gcallipo/RadioDSP_SDR_RX/Schematic_SDR_AUDIO_module.jpg

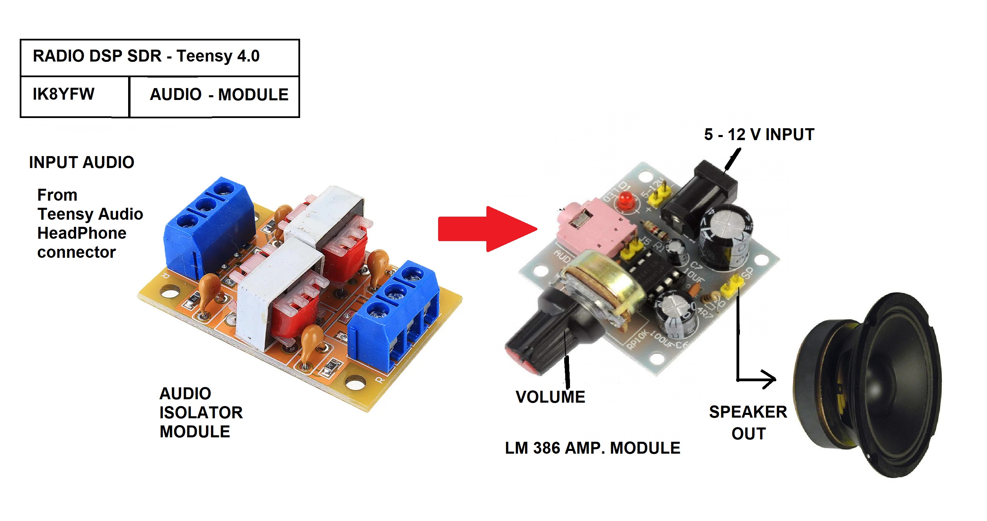
Schematic_SDR_AUDIO_module.jpg
