gcallipo/RadioDSP_SDR_RX/Schematic_SDR_RX_module.jpg

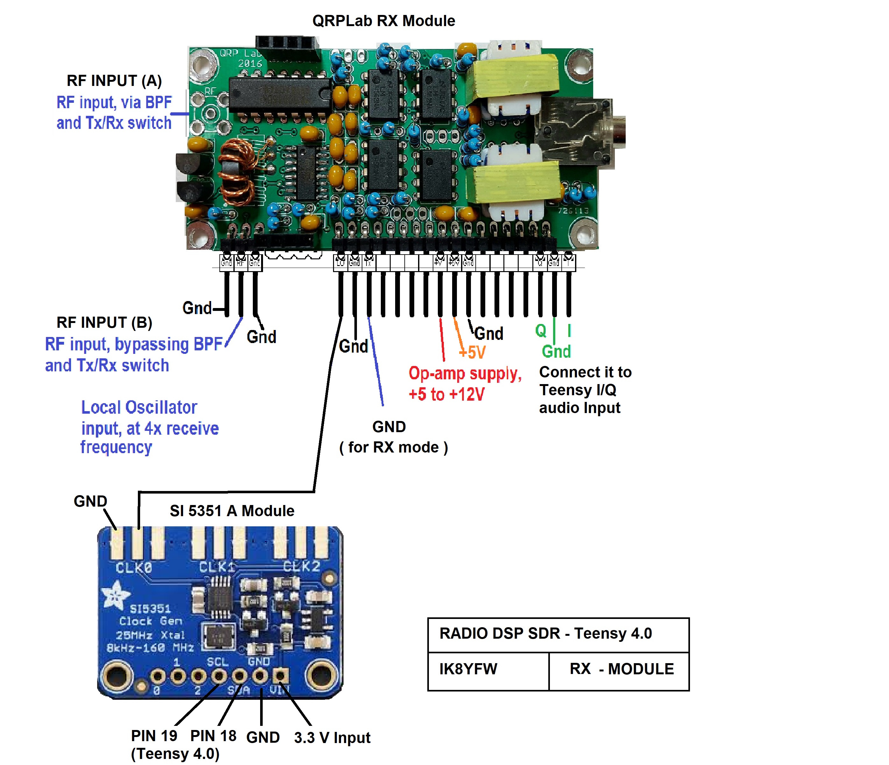
Schematic_SDR_RX_module.jpg
