gcallipo/RadioDSP_SDR_RX/README.md

# RadioDSP_SDR_RX
This project define a simple shortwave all mode and general coverage Software Defined Radio receiver.

Test reception videos

Video 1: RX 40 mt SSB Listening
https://youtu.be/ZIjYX50kgN4

Video 2: Listening SSB and testing Filters and NR
https://youtu.be/BSlDd761dBY

Video 3: RX 40 mt band SSB test Noise Reduction.
https://youtu.be/gWk815RVQAg

Video 4: RX 20 mt band CW test Noise Reduction on CW signal.
https://youtu.be/HTplyrWu3lA

Video 5: RX 20 mt band CW test Auto Notch filter.
https://youtu.be/WXXLD94oXxc

Video 6: RX 40 mt band SSB, extreme QRM noise corrupted signal and Noise reduction action.
https://youtu.be/_-evbWLCN_s

NOTE:
(Updated on 21.02.2021)
