gcallipo/RadioDSP_SDR_RX/RX_Screen2.jpg

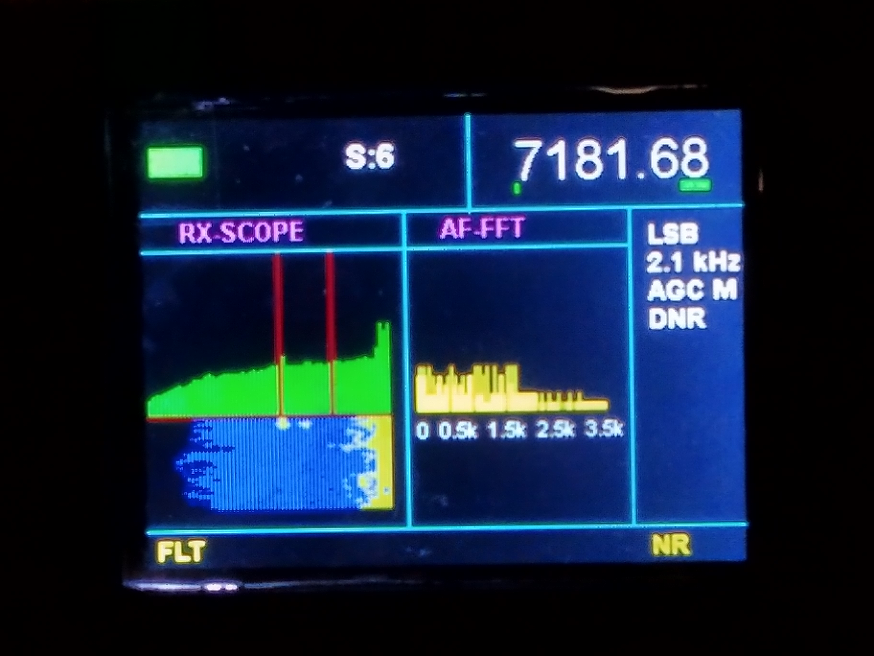
RX_Screen2.jpg
