gcallipo/RadioDSP_SDR_RX/RX_Screen.jpg

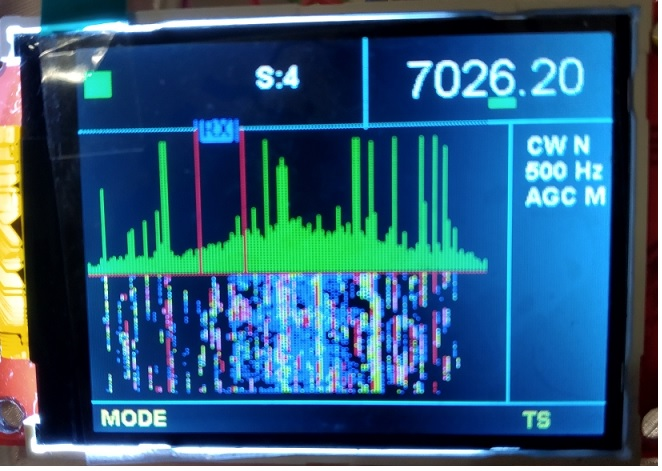
RX_Screen.jpg
