gcallipo/RadioDSP_SDR_RX/Schematic_SDR_CPU_module.jpg

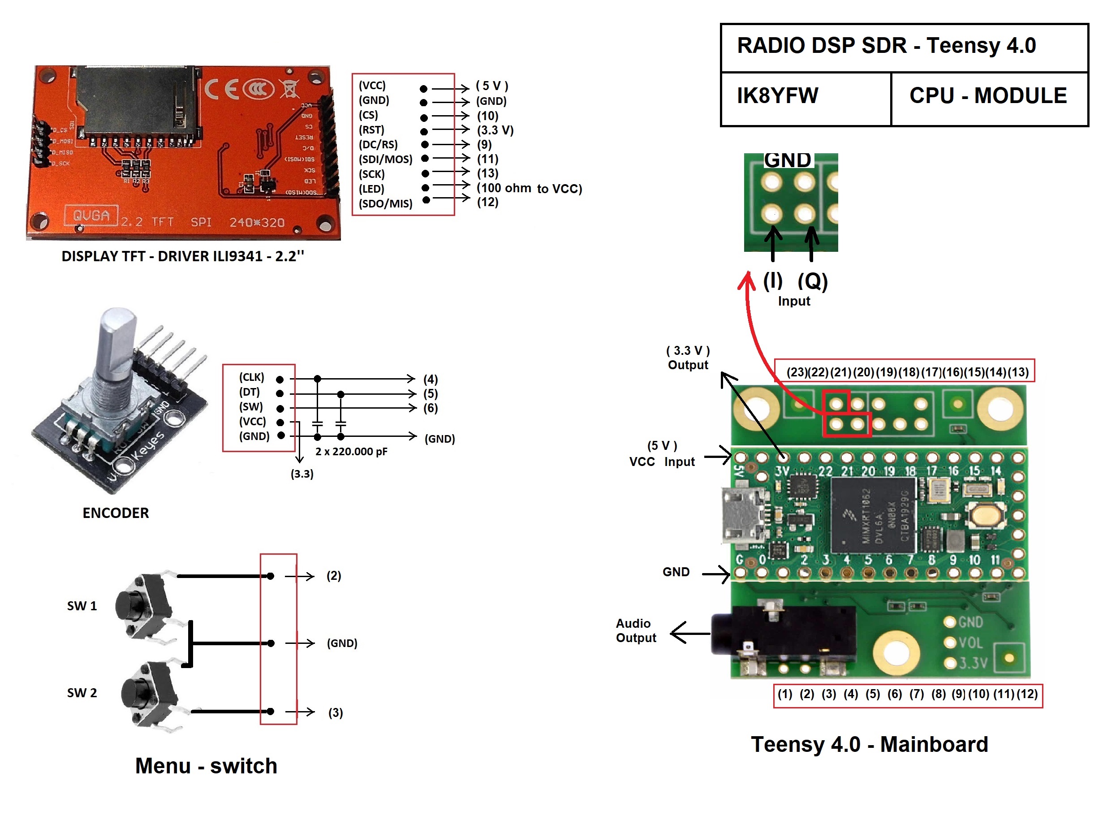
Schematic_SDR_CPU_module.jpg
