gcallipo/RadioDSP_SDR_RX/Schematic_SDR_POWER_module.jpg

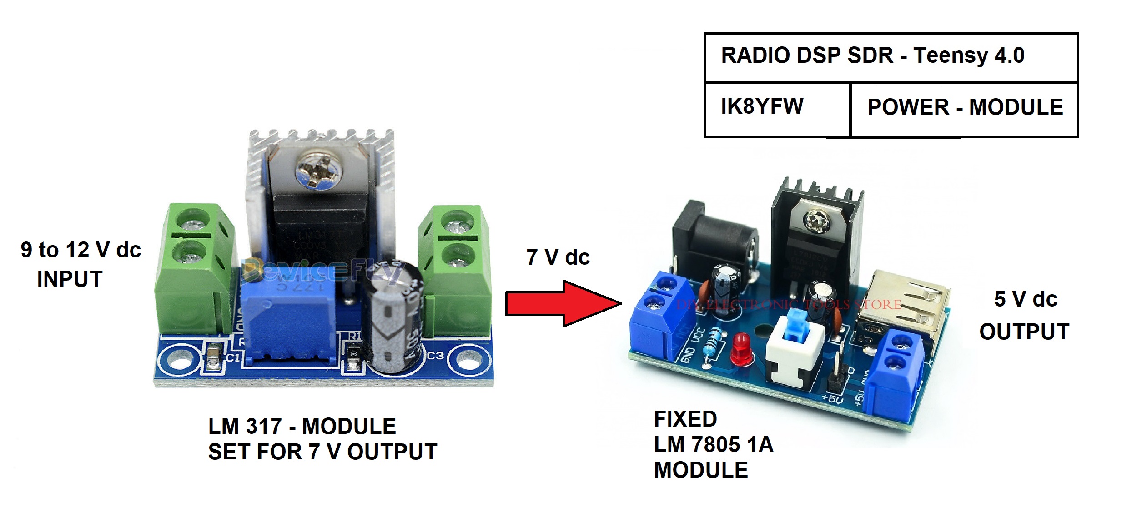
Schematic_SDR_POWER_module.jpg
