gcallipo/RadioDSP_SDR_RX/(threads)

Thread 1 (2021-02-03):

RadioDSP_SDR_RX.

Haranochi, 2021-02-03:
Ciao, voglio conoscere qualche dettaglio in più sul tuo progetto per costruirlo, dove posso ottenere una schema del progetto. Grazie mille.

José María

gcallipo, 2021-02-03:
Hi, thanks for interesting in the project,
I'm working on It and I'm planning to add full descrptiption and schematics in the next weeks.
At the moment you can follows us in two group that we use to build the sdr, the group:.  
https://groups.io/g/keithsdr
And the Facebook group.   keiths_sdr
I'm working starting from an idea of the work that me, Keith and other OMS are started and create my own project with other functionality.
I Hope  to see you in the groups .
Best 73 de Giuseppe Ik8yfw

Inviato da Libero Mail per Android mercoledì, 03 febbraio 2021, 04:28PM +01:00 da Haranochi  notifications@github.com :

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

Haranochi, 2021-02-03:
Hi,
Thank you for responding quickly, I have requested to join the group https://groups.io/g/keithsdr and I await the approval of the moderator.
I follow your project with great interest. Thank.

José María

Closed 2021-02-03.

Thread 2 (2021-02-15):

New questions.

Haranochi, 2021-02-15:
Hi Giuseppe,
 When I got home from the Faculty I visited your github page and I verify that you put the diagrams of your project (test) of the sdr receiver that you have built. Thanks for the time and effort.

When I look at the .ino files in the src folder, I see two more folders, RadioDSP_SDR_RX and tests.

In the RDSP_general_includes.h file, lines 49, 50 and 51.

 // Define 3 buttons for menu operation
#define BUTTON_D2  2 // Switch 1
#define BUTTON_D3  6 // Encoder switch
#define BUTTON_D6  3 // Switch 2

Additional comments are notes to me.

In the test file, RadioDSP_SDR_RX_Conv.ino:

// Define 3 buttons for menu operation
#define BUTTON_D2  2
#define BUTTON_D3  3
#define BUTTON_D6  6

In the file RDSP_general_includes.h, BUTTON_D3 6 and BUTTON_D6 3, my question why you change those pins.

I have compiled with no errors, just two warnings, the RadioDSP_SDR_RX sketch. Now I just have to build it.

Another question why use teensy 4.0 and not 3.6, due to its higher speed ARM.

I want to try compiling the sketch for teensy 3.6, I have an unused one at home and an audio adapter board so I don't have to buy the teensy 4.0 and audio adapter boards for 4.0. or adapt the wiring of the audio adapter boards 3.6 to 4.0. I want to modify arm_math.h file from CMSIS library version 4.5.0, is it possible to do it? If possible I prefer that you do not tell me how, I want to do it myself, if it is not possible please tell me.

Regards,
José María

gcallipo, 2021-02-15:
The tests dir Is Just a backup for some experiments you can skip It.  The project at the moment works on audiosdr library originally created for teensy 3.5/6, then I think that you don't have problems to recompile It on 3.6.  If you see some lack on running you can turn off the Convolutional and Noise reduction section to reduce load.
The project Is quite completed I've to adjust and fix some minor bug on menù and mybe to change the si5351  library for the best si5351mcu to reduce noise on frequency change.
That's all for now.
Thanks for your interest on project.
Best wishes G.
--
Inviato da Libero Mail per Android lunedì, 15 febbraio 2021, 11:12PM +01:00 da Haranochi  notifications@github.com :

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

gcallipo, 2021-02-15:
For the CMSIS I don't try in this project. I worked on stm32 platform and changed also some versions, but here,  I don't know if an upgrade can create problems on original Teensy basic audio library or the audiosdr. Check both the library references: Teensy audio library and the audio are lib.
G.
--
Inviato da Libero Mail per Android lunedì, 15 febbraio 2021, 11:12PM +01:00 da Haranochi  notifications@github.com :

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

Closed 2021-02-20.

Thread 3 (2021-03-03):

Receiver built in stripboard.

Haranochi, 2021-03-03:
Hi,

Finally the board 4.0 arrived, and I finished the construction of the receiver, now it is a frankenstein, there are more cables because I have used the audio adapter rev.B the next step is to design the pcb, I will do three and I can send you one if he wants her. The display used is 2.4 ".

Regards.

José María
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

gcallipo, 2021-03-03:
Really impressive It look great ,
Thanks for posting you result.
I Hope to continue the experiments
In the next weeks, I Will works only
In the firmware without changing the
Hardware.
Stay tuned for updates.
Vy 73 de IK8YFW.
--
Inviato da Libero Mail per Android mercoledì, 03 marzo 2021, 11:04PM +01:00 da Haranochi  notifications@github.com :

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

Thread 4 (2021-03-25):

Receiver finalized.

Haranochi, 2021-03-25:
Hi,

I finished my second semester exams and I was able to finish the receiver, thanks for your software, so that the rotary encoder works in a clockwise direction I have changed the wiring, CLK pin 5 and DT pin 4, I look forward to PBT L and PBT H be active. Now I have time to have fun with the receiver.

Regards.

José María
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

gcallipo, 2021-03-25:
That's good notice. To use the Low and High cut filtering, take the related func button pressed when rotate the tuning control. This Dynamic filter help you to change upper or lower side of filter.
Have a nice listening and stay tuned for news.
73 de IK8YFW
--
Inviato da Libero Mail per Android giovedì, 25 marzo 2021, 10:50PM +01:00 da Haranochi  ***@***.*** :

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

gcallipo, 2021-03-28:
I have a notice that the audiosdr library ( the engine on my project ) have a new release that solve the distorsions problem on AM demodulation. I cannot test It at the moment because I'm working in other sdr chain. If you dewnload It and recompile the project please send me the results of tests if possible.
G.
--
Inviato da Libero Mail per Android giovedì, 25 marzo 2021, 10:50PM +01:00 da Haranochi  ***@***.*** :

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

Haranochi, 2021-03-28:
Hi Guiseppe,

Thanks for your notice, happy to be able to test your new modifications, a question, the files downloaded from your github page once unzipped are dated February 21, these are the ones that contain your latest sdr library. And thanks for showing me how the high and low cut filters work. I send you my comments.

José María

gcallipo, 2021-03-28:
No, the news are in the external library audiosdr that I used in compile, you must download latest audiosdr and recompile my project.
You can find the library here:
https://github.com/DerekRowell/AudioSDR
--
Inviato da Libero Mail per Android domenica, 28 marzo 2021, 01:35PM +02:00 da Haranochi  ***@***.*** :

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

Haranochi, 2021-03-28:
Hi Giuseppe,

After adding the file "core_cm4_simd.h" to / Arduino / teensy / avr / cores / teensy4, it compiled without problems, only three warnings:

RDSP_convolutional.h: In function 'void doConvolutionalProcessing (float, boolean, double, double)':
RDSP_convolutional.h: 231: warning: comparison between signed and unsigned integer expressions
     if (Q_in_L.available ()> N_BLOCKS + 0 && Q_in_R.available ()> N_BLOCKS + 0)

RDSP_convolutional.h: 231: warning: comparison between signed and unsigned integer expressions
     if (Q_in_L.available ()> N_BLOCKS + 0 && Q_in_R.available ()> N_BLOCKS + 0)

RDSP_convolutional.h: 342: warning: comparison between signed and unsigned integer expressions
       for (int i = 0; i <N_BLOCKS; i ++)

RDSP_display.h: In function 'void Update_AudioSpectrum ()':
RDSP_display.h: 214: warning: unused variable 'low'
   int low = 5;

I have downloaded it to the Teensy and begin testing this afternoon / evening. When I make the comparisons I will tell you, if you think it is convenient I can send you a file with the audios.

José María

Haranochi, 2021-03-28:
Hi,

Attached pre_compiled file.

José María

[RadioDSP_SDR_RX.ino.zip](https://github.com/gcallipo/RadioDSP_SDR_RX/files/6217592/RadioDSP_SDR_RX.ino.zip)

gcallipo, 2021-03-28:
Great!

I upload the binary, now the AM mode works really well, you can tune it better without distorsion or tone.

G.

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

Giuseppe Callipo, (IK8YFW)

VIA CRISTOFORO COLOMBO N.45
84090 MONTECORVINO PUGLIANO (SA)
ITALY

Haranochi, 2021-03-28:
Wonderful improvement!

Yes, this really works, better hearing and distorted voices that prevented a pleasant hearing disappeared, your receiver got a big improvement. Great.

José María
