gcallipo/RadioDSP_SDR_RX/(commit log)

2020-12-25 Refactoring code
    Refactoring code
    Added DNR
    Spectrum subtractin Noise Reduction.
    [RDSP_controls.h, RDSP_convolutional.h, RDSP_display.h, RDSP_general_includes.h, RadioDSP_SDR_RX.ino]
2021-01-07 Add Normalized LMS
    Added normazized LMS noise reduction and structure for additional audio filter.
    [RDSP_controls.h, RDSP_convolutional.h, RDSP_convolutional_spec.h, RDSP_noise_reduction.h, RadioDSP_SDR_RX.ino]
2021-02-13 Schematic block
    Update Schematic block
2021-02-20 Refactoring prj
    Fix some bugs and
    speedy the vfo.
    [RDSP_controls.h, RDSP_convolutional_spec.h, RDSP_general_includes.h, RadioDSP_SDR_RX.ino, RadioDSP_SDR_RX_Conv.ino]
2021-02-21 Minor fix
    Minor fix.
    update 21.02.2021
    [RDSP_controls.h, RDSP_display.h, RadioDSP_SDR_RX.ino]
